PatrykSzydlik/SQuick_kicad/README.md

**Contributors:**

Piotr Gorzelnik

Patryk Szydlik

**Project:**

Squick Micromouse

**Brief:**

Repository contains all KiCAD projects related to development of electrical schematics and PCB board project.

**Repository Content:** 

 -- 	Squick (main KiCAD project)
