PatrykSzydlik/SQuick_kicad/Squick/Squick.kicad_pcb

## KiCad design Squick/Squick.kicad_pcb (2021-06-06)

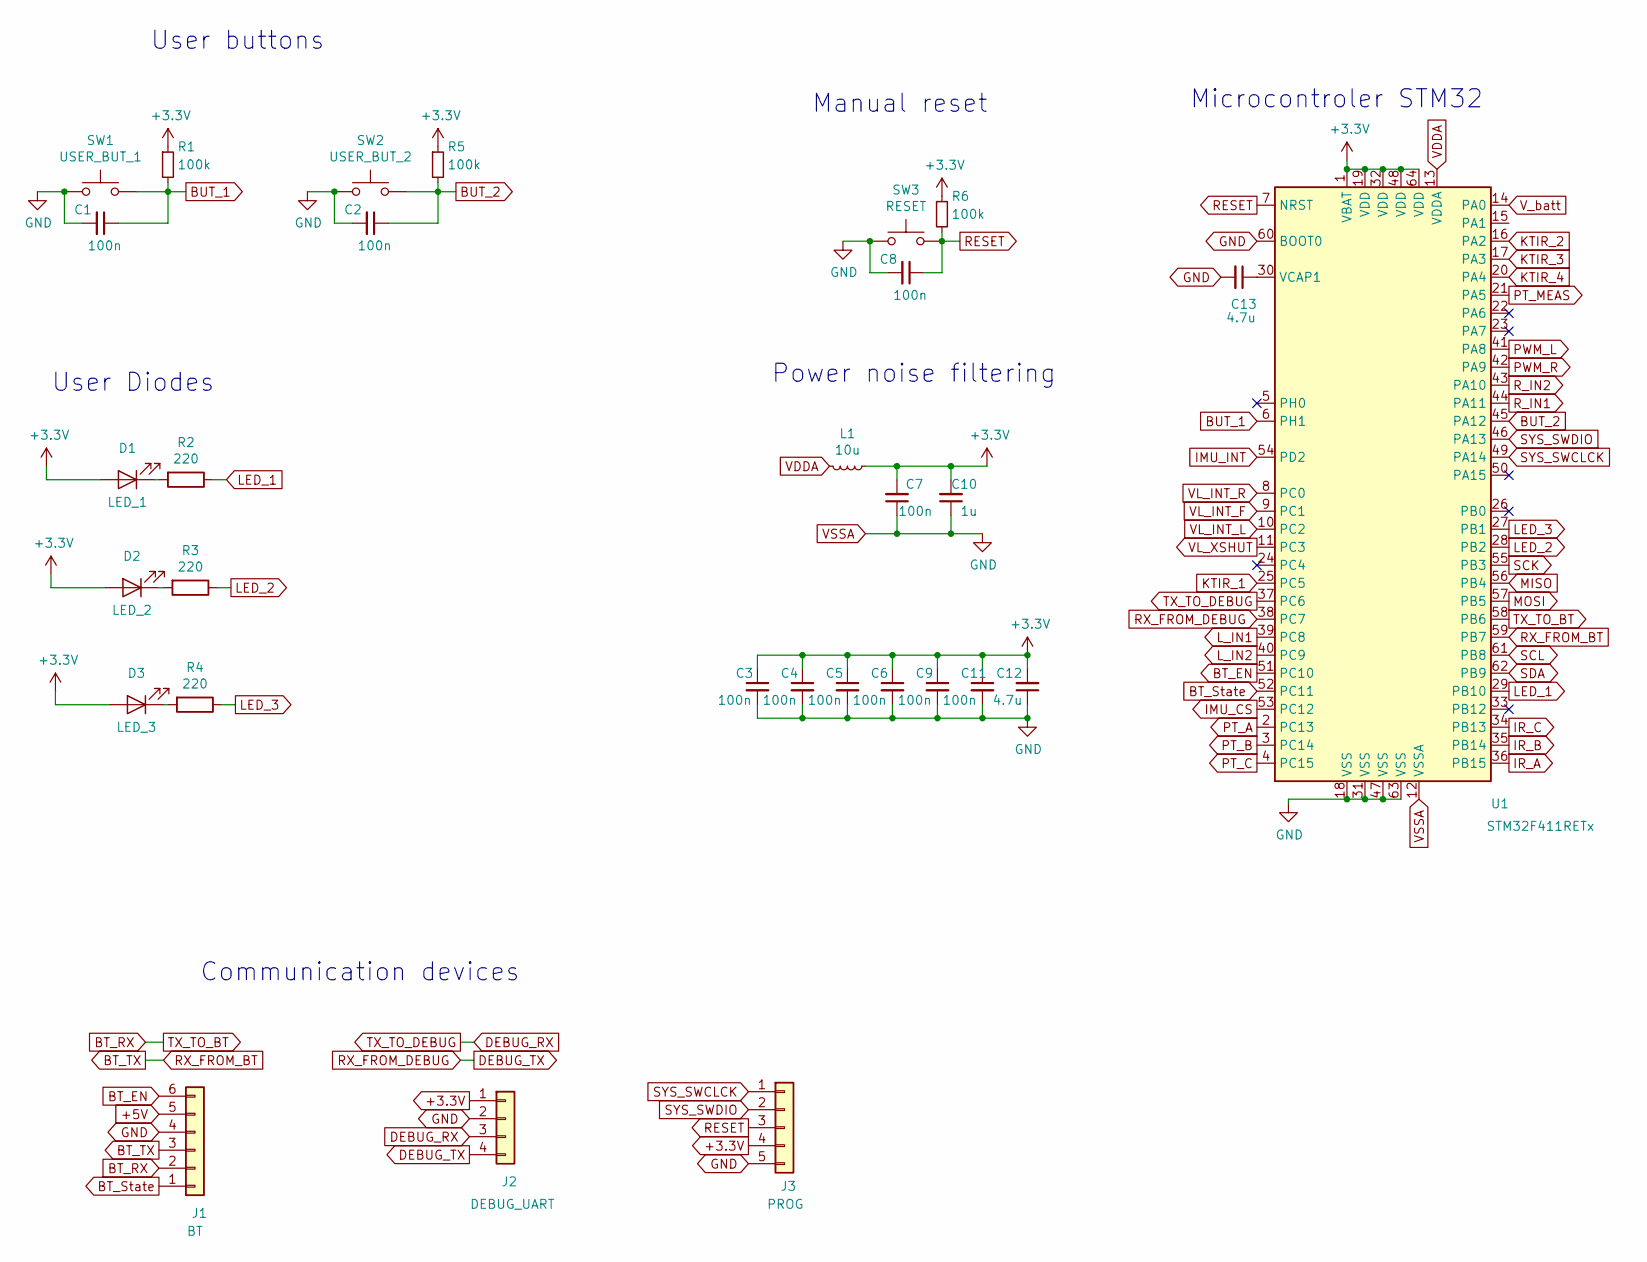
[picture p1: schematic STM32F4.sch]

Parts:
C1, C2, C3, C4, C5, C6, C7, C8, C9, C11: 100n; C_0603_1608Metric_Pad1.05x0.95mm_HandSolder
C10: 1u; C_0603_1608Metric_Pad1.05x0.95mm_HandSolder
C12, C13: 4.7u; C_0603_1608Metric_Pad1.05x0.95mm_HandSolder
D1: LED_1; LED_0603_1608Metric_Pad1.05x0.95mm_HandSolder
D2: LED_2; LED_0603_1608Metric_Pad1.05x0.95mm_HandSolder
D3: LED_3; LED_0603_1608Metric_Pad1.05x0.95mm_HandSolder
J1: BT; PinSocket_1x06_P2.54mm_Vertical
J2: DEBUG_UART; PinSocket_1x04_P2.54mm_Vertical
J3: PROG; PinSocket_1x05_P2.54mm_Vertical
L1: 10u; L_0603_1608Metric_Pad1.05x0.95mm_HandSolder
R1, R5, R6: 100k; R_0603_1608Metric_Pad1.05x0.95mm_HandSolder
R2, R3, R4: 220; R_0603_1608Metric_Pad1.05x0.95mm_HandSolder
SW1: USER_BUT_1; SW_DIP_SPSTx01_Slide_6.7x4.1mm_W6.73mm_P2.54mm_LowProfile_J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
SW2: USER_BUT_2; SW_DIP_SPSTx01_Slide_6.7x4.1mm_W6.73mm_P2.54mm_LowProfile_J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
SW3: RESET; SW_DIP_SPSTx01_Slide_6.7x4.1mm_W6.73mm_P2.54mm_LowProfile_J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
U1: STM32F411RETx; LQFP-64_10x10mm_P0.5mm

Connections:
+3.3V: C3.1, C4.1, C5.1, C6.1, C7.2, C9.1, C10.2, C11.1, C12.2, D1.2 (A), D2.2 (A), D3.2 (A), J2.1, J3.4, L1.1, R1.1, R5.1, R6.1, U1.1 (VBAT), U1.19 (VDD), U1.32 (VDD), U1.48 (VDD), U1.64 (VDD); also elsewhere on the board
+5V: J1.5; also elsewhere on the board
BT_EN: J1.6, U1.51 (PC10)
BT_RX: J1.2, U1.58 (PB6)
BT_State: J1.1, U1.52 (PC11)
BT_TX: J1.3, U1.59 (PB7)
BUT_1: C1.1, R1.2, SW1.2, U1.6 (PH1)
BUT_2: C2.1, R5.2, SW2.2, U1.45 (PA12)
DEBUG_RX: J2.3, U1.37 (PC6)
DEBUG_TX: J2.4, U1.38 (PC7)
GND: C1.2, C2.2, C3.2, C4.2, C5.2, C6.2, C7.1, C8.2, C9.2, C10.1, C11.2, C12.1, C13.2, J1.4, J2.2, J3.5, SW1.1, SW2.1, SW3.1, U1.12 (VSSA), U1.18 (VSS), U1.31 (VSS), U1.47 (VSS), U1.60 (BOOT0), U1.63 (VSS); also elsewhere on the board
IMU_CS: U1.53 (PC12); also elsewhere on the board
IMU_INT: U1.54 (PD2); also elsewhere on the board
IR_A: U1.36 (PB15); also elsewhere on the board
IR_B: U1.35 (PB14); also elsewhere on the board
IR_C: U1.34 (PB13); also elsewhere on the board
KTIR_1: U1.15 (PA1); also elsewhere on the board
KTIR_2: U1.16 (PA2); also elsewhere on the board
KTIR_3: U1.17 (PA3); also elsewhere on the board
KTIR_4: U1.20 (PA4); also elsewhere on the board
LED_1: R2.1, U1.29 (PB10)
LED_2: R3.1, U1.28 (PB2)
LED_3: R4.1, U1.27 (PB1)
L_IN1: U1.39 (PC8); also elsewhere on the board
L_IN2: U1.40 (PC9); also elsewhere on the board
MISO: U1.56 (PB4); also elsewhere on the board
MOSI: U1.57 (PB5); also elsewhere on the board
unnamed: C13.1, U1.30 (VCAP1)
unnamed: D1.1 (K), R2.2
unnamed: D2.1 (K), R3.2
unnamed: D3.1 (K), R4.2
PT_A: U1.2 (PC13); also elsewhere on the board
PT_B: U1.3 (PC14); also elsewhere on the board
PT_C: U1.4 (PC15); also elsewhere on the board
PT_MEAS: U1.21 (PA5); also elsewhere on the board
PWM_L: U1.41 (PA8); also elsewhere on the board
PWM_R: U1.42 (PA9); also elsewhere on the board
RESET: C8.1, J3.3, R6.2, SW3.2, U1.7 (NRST)
R_IN1: U1.44 (PA11); also elsewhere on the board
R_IN2: U1.43 (PA10); also elsewhere on the board
SCK: U1.55 (PB3); also elsewhere on the board
SCL: U1.61 (PB8); also elsewhere on the board
SDA: U1.62 (PB9); also elsewhere on the board
SYS_SWCLCK: J3.1, U1.49 (PA14)
SYS_SWDIO: J3.2, U1.46 (PA13)
VDDA: L1.2, U1.13 (VDDA)
VL_INT_F: U1.9 (PC1); also elsewhere on the board
VL_INT_L: U1.10 (PC2); also elsewhere on the board
VL_INT_R: U1.8 (PC0); also elsewhere on the board
VL_XSHUT: U1.11 (PC3); also elsewhere on the board
V_batt: U1.14 (PA0); also elsewhere on the board

Notes on the sheet:
Communication devices
Power noise filtering
Manual reset
Microcontroler STM32
User buttons
User Diodes

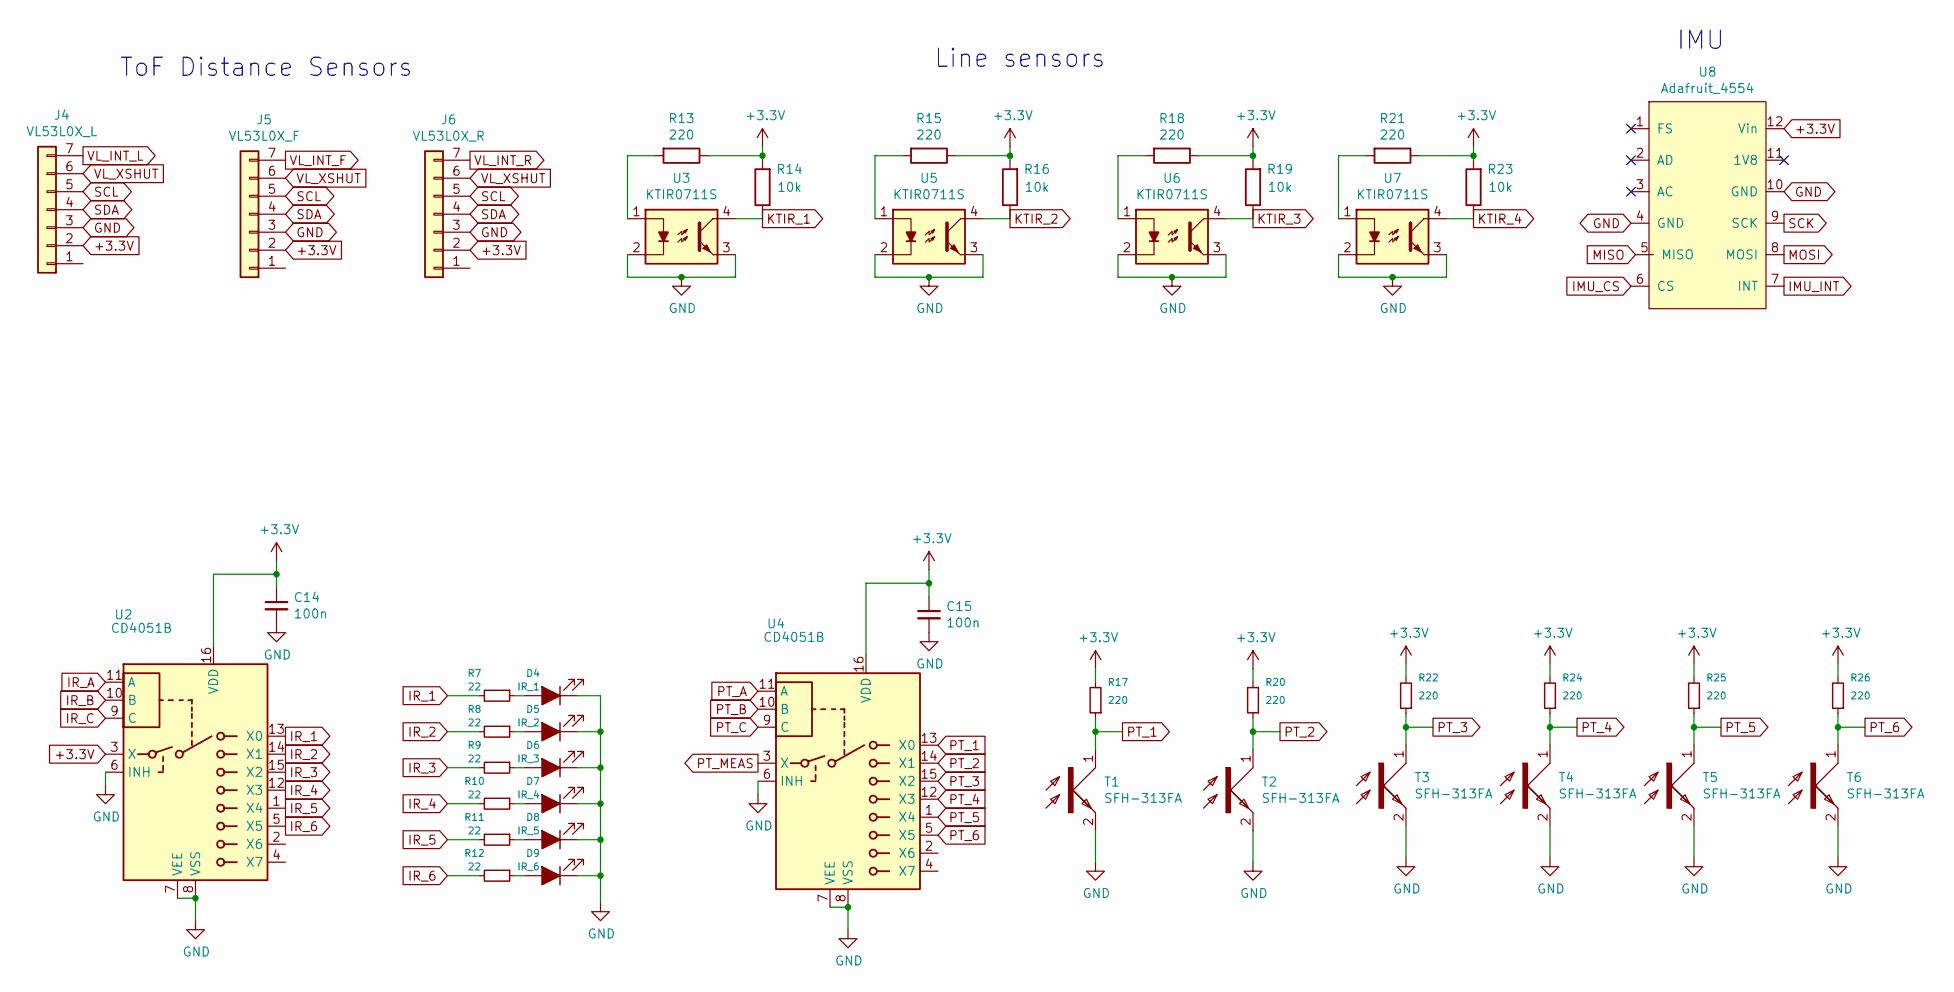
[picture p2: schematic Sensors.sch]

Parts:
C14, C15: 100n; C_0603_1608Metric_Pad1.05x0.95mm_HandSolder
D4: IR_1; LED_D5.0mm
D5: IR_2; LED_D5.0mm
D6: IR_3; LED_D5.0mm
D7: IR_4; LED_D5.0mm
D8: IR_5; LED_D5.0mm
D9: IR_6; LED_D5.0mm
J4: VL53L0X_L; PinSocket_1x07_P2.54mm_Vertical
J5: VL53L0X_F; PinSocket_1x07_P2.54mm_Vertical
J6: VL53L0X_R; PinSocket_1x07_P2.54mm_Vertical
R7, R8, R9, R10, R11, R12: 22; R_0603_1608Metric_Pad1.05x0.95mm_HandSolder
R13, R15, R17, R18, R20, R21, R22, R24, R25, R26: 220; R_0603_1608Metric_Pad1.05x0.95mm_HandSolder
R14, R16, R19, R23: 10k; R_0603_1608Metric_Pad1.05x0.95mm_HandSolder
T1, T2, T3, T4, T5, T6: SFH-313FA; LED_D5.0mm
U2, U4: CD4051B; SOIC-16W_5.3x10.2mm_P1.27mm
U3, U5, U6, U7: KTIR0711S
U8: Adafruit_4554; IMU_LSM9DS1_Adafruit4634

Connections:
+3.3V: C14.1, C15.1, J4.2, J5.2, J6.2, R13.1, R14.2, R15.1, R16.2, R17.2, R18.1, R19.2, R20.2, R21.1, R22.2, R23.2, R24.2, R25.2, R26.2, U2.3 (X), U2.16 (VDD), U4.16 (VDD), U8.12 (Vin); also elsewhere on the board
GND: C14.2, C15.2, D4.1 (K), D5.1 (K), D6.1 (K), D7.1 (K), D8.1 (K), D9.1 (K), J4.3, J5.3, J6.3, T1.2, T2.2, T3.2, T4.2, T5.2, T6.2, U2.6 (INH), U2.7 (VEE), U2.8 (VSS), U3.2, U3.3, U4.6 (INH), U4.7 (VEE), U4.8 (VSS), U5.2, U5.3, U6.2, U6.3, U7.2, U7.3, U8.4 (GND), U8.10 (GND); also elsewhere on the board
IMU_CS: U8.6 (CS); also elsewhere on the board
IMU_INT: U8.7 (INT); also elsewhere on the board
IR_1: R7.2, U2.13 (X0)
IR_2: R8.2, U2.14 (X1)
IR_3: R9.2, U2.15 (X2)
IR_4: R10.2, U2.12 (X3)
IR_5: R11.2, U2.1 (X4)
IR_6: R12.2, U2.5 (X5)
IR_A: U2.11 (A); also elsewhere on the board
IR_B: U2.10 (B); also elsewhere on the board
IR_C: U2.9 (C); also elsewhere on the board
KTIR_1: R14.1, U3.4; also elsewhere on the board
KTIR_2: R16.1, U5.4; also elsewhere on the board
KTIR_3: R19.1, U6.4; also elsewhere on the board
KTIR_4: R23.1, U7.4; also elsewhere on the board
MISO: U8.5 (MISO); also elsewhere on the board
MOSI: U8.8 (MOSI); also elsewhere on the board
unnamed: D4.2 (A), R7.1
unnamed: D5.2 (A), R8.1
unnamed: D6.2 (A), R9.1
unnamed: D7.2 (A), R10.1
unnamed: D8.2 (A), R11.1
unnamed: D9.2 (A), R12.1
unnamed: R13.2, U3.1
unnamed: R15.2, U5.1
unnamed: R18.2, U6.1
unnamed: R21.2, U7.1
PT_1: R17.1, T1.1, U4.13 (X0)
PT_2: R20.1, T2.1, U4.14 (X1)
PT_3: R22.1, T3.1, U4.15 (X2)
PT_4: R24.1, T4.1, U4.12 (X3)
PT_5: R25.1, T5.1, U4.1 (X4)
PT_6: R26.1, T6.1, U4.5 (X5)
PT_A: U4.11 (A); also elsewhere on the board
PT_B: U4.10 (B); also elsewhere on the board
PT_C: U4.9 (C); also elsewhere on the board
PT_MEAS: U4.3 (X); also elsewhere on the board
SCK: U8.9 (SCK); also elsewhere on the board
SCL: J4.5, J5.5, J6.5; also elsewhere on the board
SDA: J4.4, J5.4, J6.4; also elsewhere on the board
VL_INT_F: J5.7; also elsewhere on the board
VL_INT_L: J4.7; also elsewhere on the board
VL_INT_R: J6.7; also elsewhere on the board
VL_XSHUT: J4.6, J5.6, J6.6; also elsewhere on the board

Notes on the sheet:
ToF Distance Sensors
IMU
Line sensors

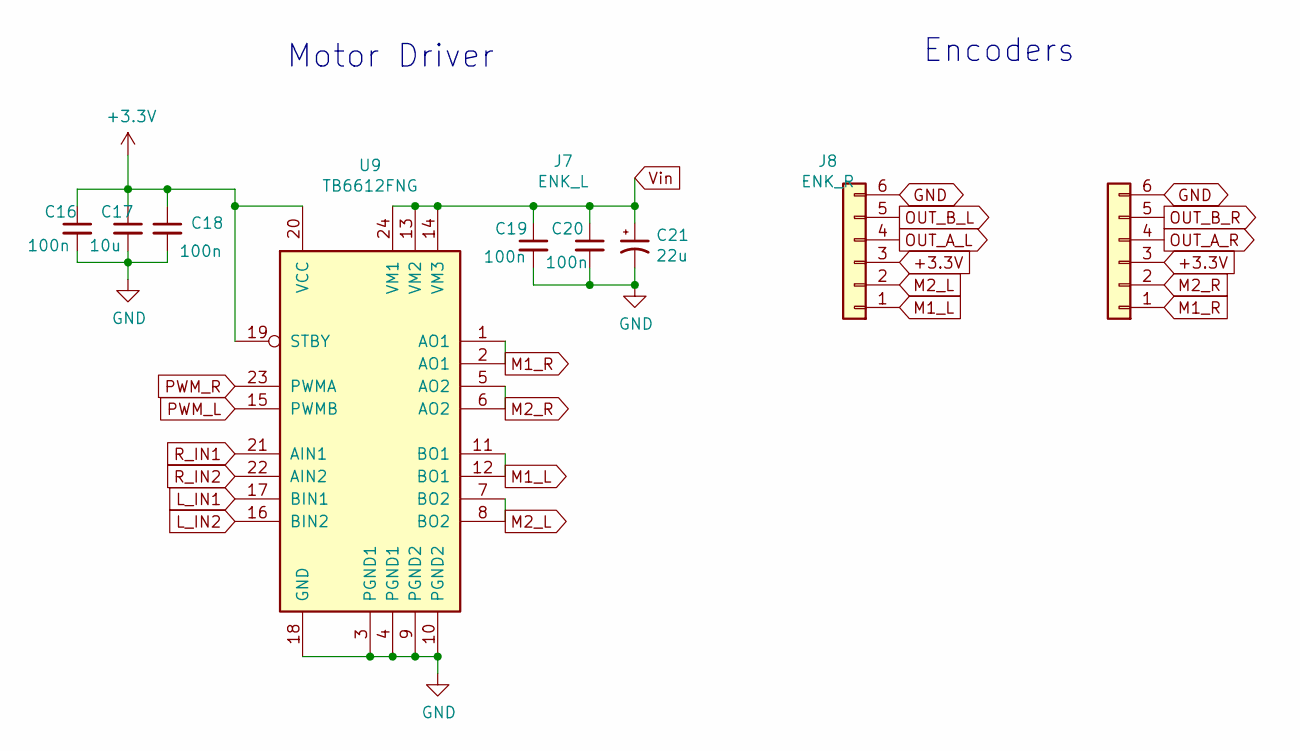
[picture p3: schematic Motor_driver.sch]

Parts:
C16, C18, C19, C20: 100n; C_0603_1608Metric_Pad1.05x0.95mm_HandSolder
C17: 10u; C_0603_1608Metric_Pad1.05x0.95mm_HandSolder
C21: 22u; CP_EIA-6032-28_Kemet-C_Pad2.25x2.35mm_HandSolder
J7: ENK_L; PinSocket_1x06_P2.00mm_Vertical
J8: ENK_R; PinSocket_1x06_P2.00mm_Vertical
U9: TB6612FNG; SSOP-24_5.3x8.2mm_P0.65mm

Connections:
+3.3V: C16.1, C17.1, C18.1, J7.3, J8.3, U9.19 (STBY), U9.20 (VCC); also elsewhere on the board
GND: C16.2, C17.2, C18.2, C19.2, C20.2, C21.2, J7.6, J8.6, U9.3 (PGND1), U9.4 (PGND1), U9.9 (PGND2), U9.10 (PGND2), U9.18 (GND); also elsewhere on the board
L_IN1: U9.17 (BIN1); also elsewhere on the board
L_IN2: U9.16 (BIN2); also elsewhere on the board
M1_L: J7.1, U9.11 (BO1), U9.12 (BO1)
M1_R: J8.1, U9.1 (AO1), U9.2 (AO1)
M2_L: J7.2, U9.7 (BO2), U9.8 (BO2)
M2_R: J8.2, U9.5 (AO2), U9.6 (AO2)
OUT_A_L: J7.4
OUT_A_R: J8.4
OUT_B_L: J7.5
OUT_B_R: J8.5
PWM_L: U9.15 (PWMB); also elsewhere on the board
PWM_R: U9.23 (PWMA); also elsewhere on the board
R_IN1: U9.21 (AIN1); also elsewhere on the board
R_IN2: U9.22 (AIN2); also elsewhere on the board
Vin: C19.1, C20.1, C21.1, U9.13 (VM2), U9.14 (VM3), U9.24 (VM1); also elsewhere on the board

Notes on the sheet:
Motor Driver
Encoders

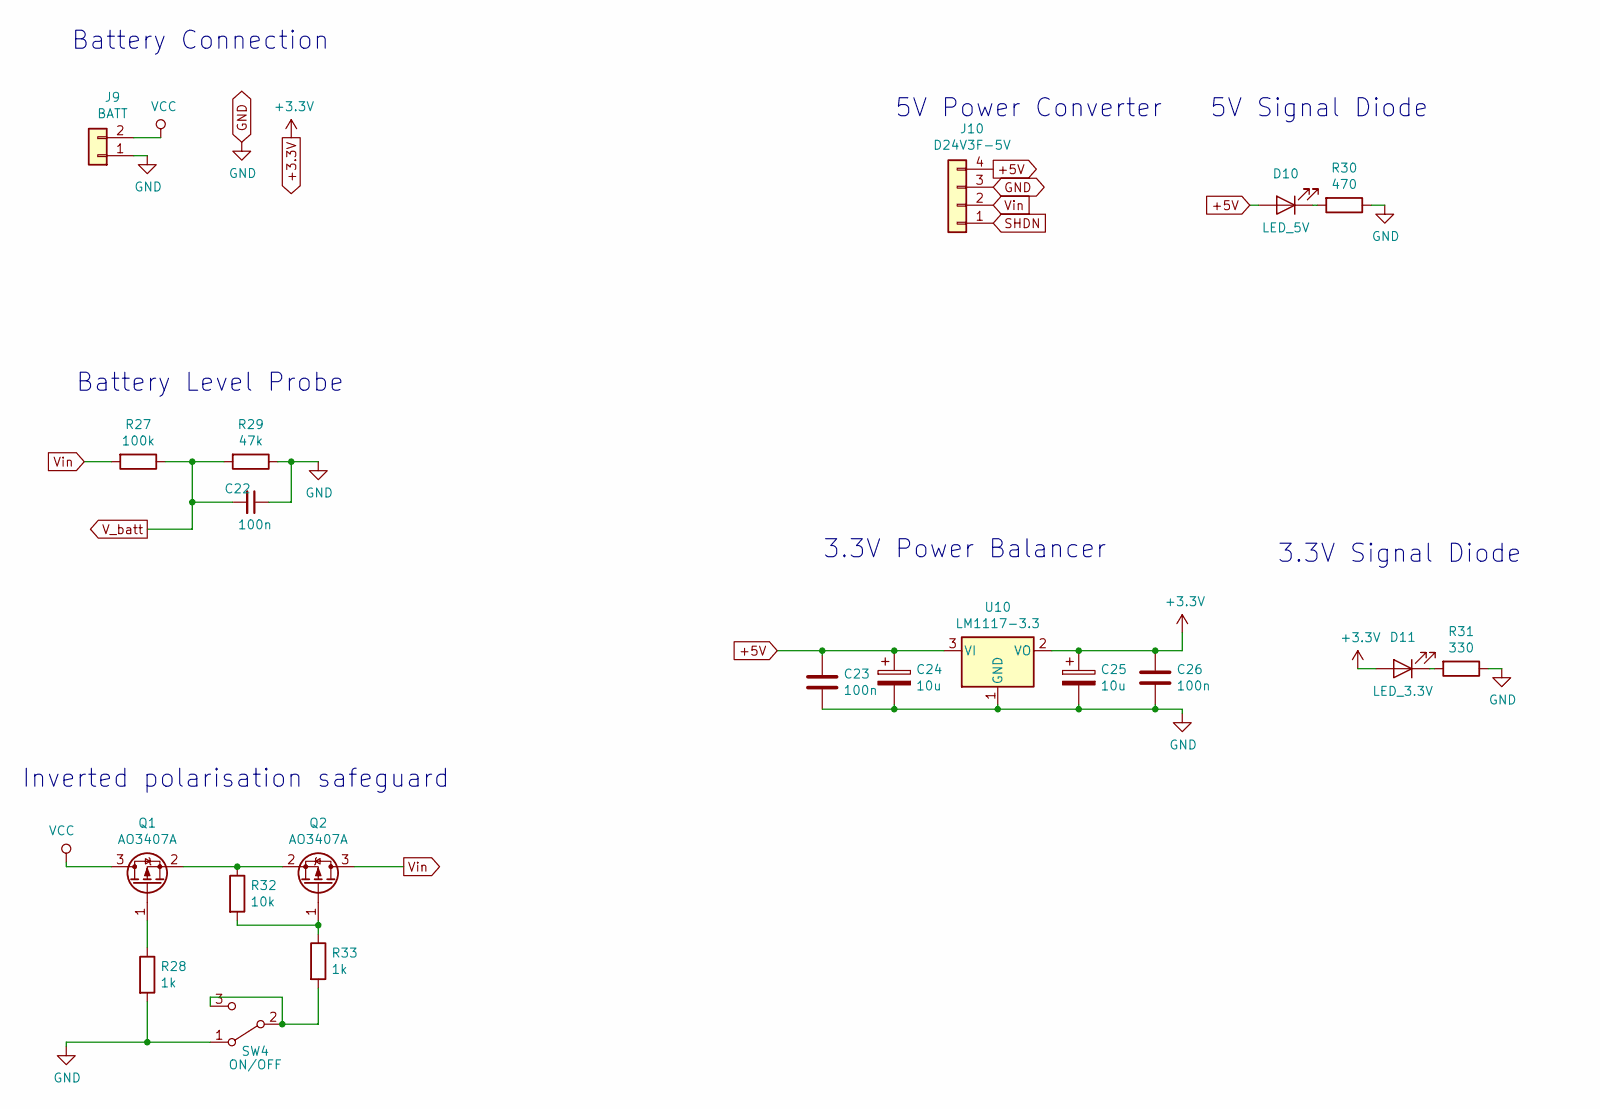
[picture p4: schematic Power_supply.sch]

Parts:
C22, C23, C26: 100n; C_0603_1608Metric_Pad1.05x0.95mm_HandSolder
C24, C25: 10u; CP_EIA-3216-18_Kemet-A_Pad1.58x1.35mm_HandSolder
D10: LED_5V; LED_0603_1608Metric_Pad1.05x0.95mm_HandSolder
D11: LED_3.3V; LED_0603_1608Metric_Pad1.05x0.95mm_HandSolder
J9: BATT; PinSocket_1x02_P2.54mm_Vertical
J10: D24V3F-5V; PinSocket_1x04_P2.54mm_Vertical
Q1, Q2: AO3407A; SOT-23_Handsoldering
R27: 100k; R_0603_1608Metric_Pad1.05x0.95mm_HandSolder
R28, R33: 1k; R_0603_1608Metric_Pad1.05x0.95mm_HandSolder
R29: 47k; R_0603_1608Metric_Pad1.05x0.95mm_HandSolder
R30: 470; R_0603_1608Metric_Pad1.05x0.95mm_HandSolder
R31: 330; R_0603_1608Metric_Pad1.05x0.95mm_HandSolder
R32: 10k; R_0603_1608Metric_Pad1.05x0.95mm_HandSolder
SW4: ON/OFF; PinSocket_1x03_P2.54mm_Vertical
U10: LM1117-3.3; SOT-223-3_TabPin2

Connections:
+3.3V: C25.1, C26.1, D11.2 (A), U10.2 (VO); also elsewhere on the board
+5V: C23.1, C24.1, D10.2 (A), J10.4, U10.3 (VI); also elsewhere on the board
GND: C22.1, C23.2, C24.2, C25.2, C26.2, J9.1, J10.3, R28.2, R29.1, R30.1, R31.1, SW4.1 (A), U10.1 (GND); also elsewhere on the board
unnamed: D10.1 (K), R30.2
unnamed: D11.1 (K), R31.2
unnamed: Q1.1 (G), R28.1
unnamed: Q1.2 (S), Q2.2 (S), R32.1
unnamed: Q2.1 (G), R32.2, R33.1
unnamed: R33.2, SW4.2 (B), SW4.3 (C)
SHDN: J10.1
VCC: J9.2, Q1.3 (D)
V_batt: C22.2, R27.1, R29.2; also elsewhere on the board
Vin: J10.2, Q2.3 (D), R27.2; also elsewhere on the board

Notes on the sheet:
Battery Connection
Inverted polarisation safeguard
5V Power Converter
3.3V Power Balancer
5V Signal Diode
3.3V Signal Diode
Battery Level Probe

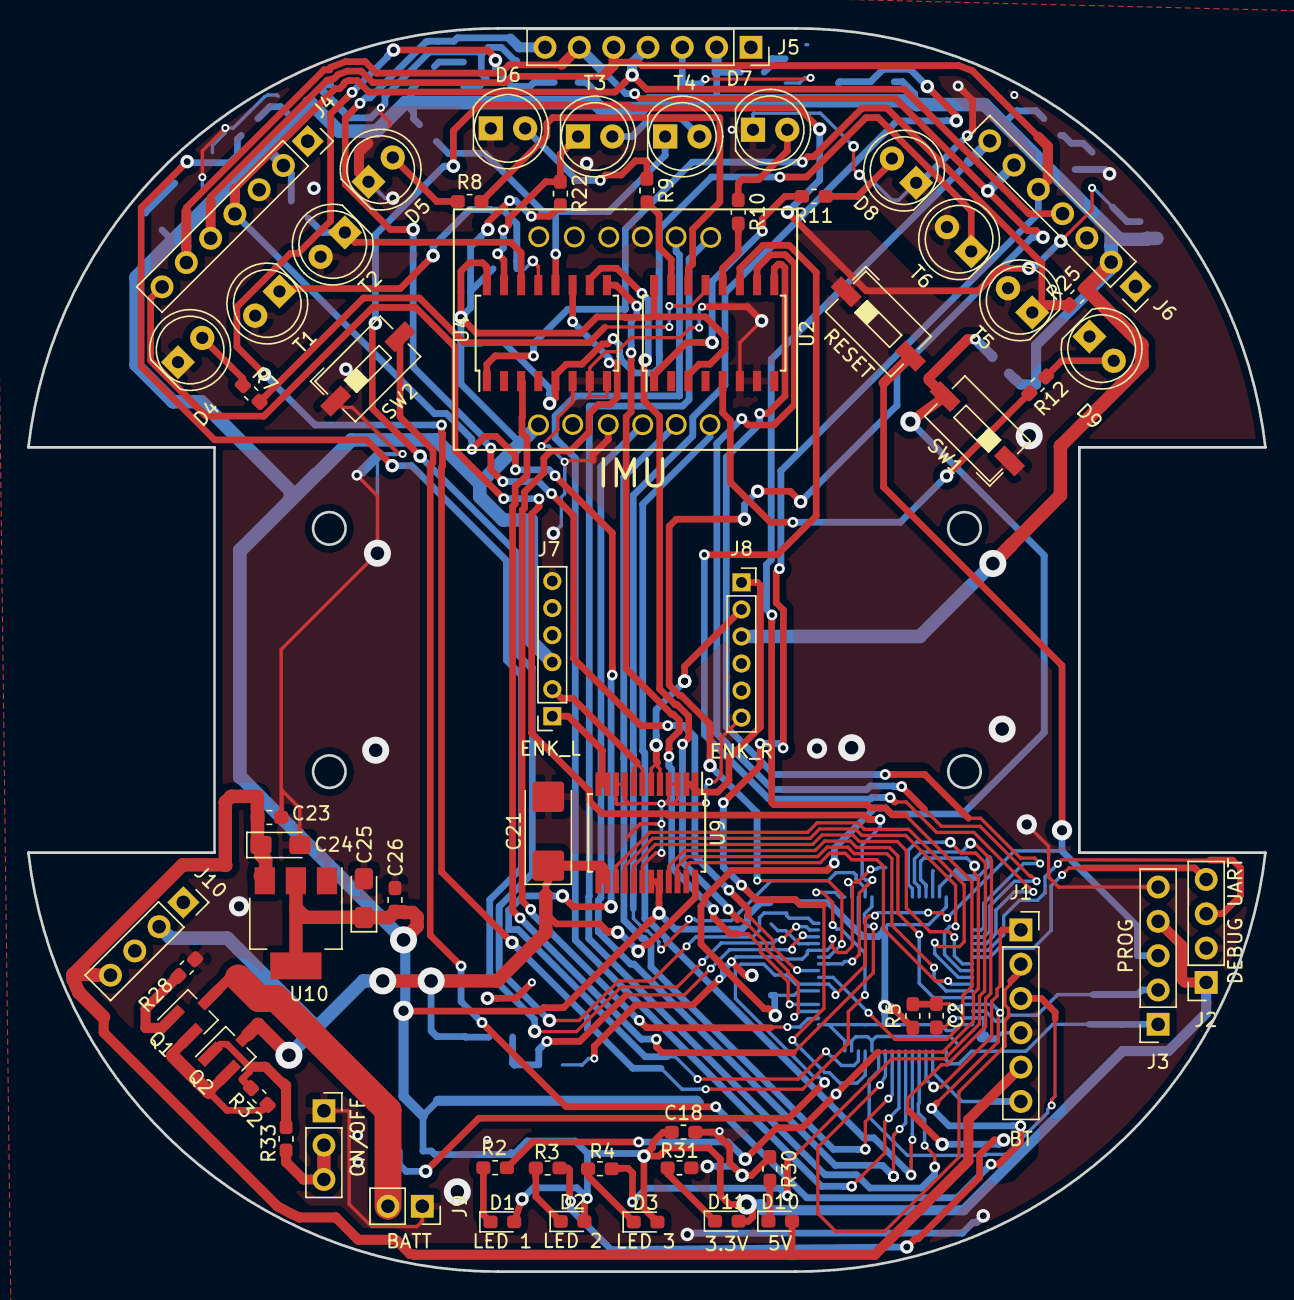
[picture p5: board Squick.kicad_pcb from above]

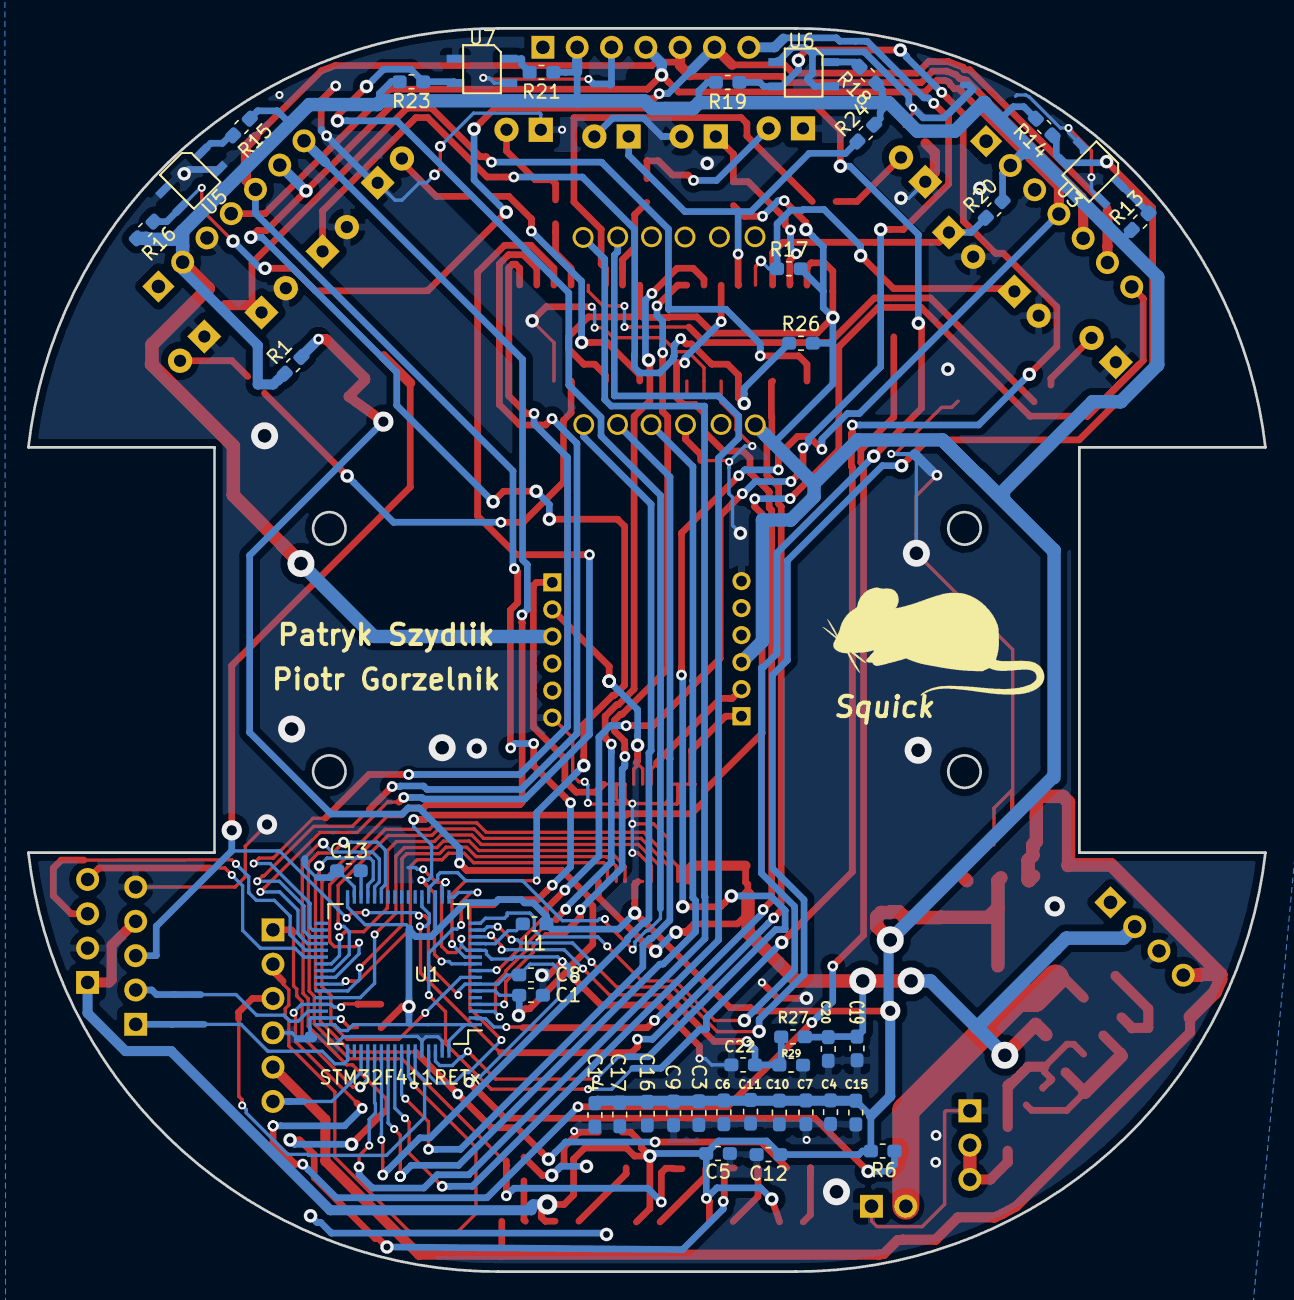
[picture p6: board Squick.kicad_pcb from below]

Board: 2 copper layers, 91.5 x 92.0 mm, 103 parts (41 on the bottom side), 85 nets.
