PatrykSzydlik/SQuick_kicad/(commit log)

2021-03-07 First day of work
    [Squick.kicad_pcb, Squick.sch]
2021-03-09 New progress in work
    [Squick.sch]
2021-03-09 End for today. Almost finished
    [Squick.sch]
2021-03-12 Updating schemes and libraries
    [Motor_driver.sch, Power_supply.sch, STM32F4.sch, Sensors.sch]
2021-03-12 Finished electrical scheme
    [STM32F4.sch]
2021-03-13 Assigned PCB footprints to schematic symbols and added footprints for KTIR and tact switches
2021-03-14 Created footprint for IMU
    [Sensors.sch]
2021-03-14 Updated pin PT_MEAS
    [Motor_driver.sch, Power_supply.sch, STM32F4.sch, Sensors.sch]
2021-03-15 Fixed footprints and symbol
    [Motor_driver.sch, Power_supply.sch, STM32F4.sch, Sensors.sch]
2021-03-16 Progress with PCB and some footprint debugs
    [Motor_driver.sch, Power_supply.sch, STM32F4.sch, Sensors.sch, Squick.kicad_pcb]
2021-03-17 Progress with PCB and size reducement
    [Squick.kicad_pcb]
2021-03-20 Major progress with PCB design
    [Power_supply.sch, Squick.kicad_pcb]
2021-03-20 PCB project almost finished (without connections)
    [Power_supply.sch, Squick.kicad_pcb]
2021-03-21 Changed IMU and assigned 0603 footprints
    [Motor_driver.sch, Power_supply.sch, STM32F4.sch, Sensors.sch, Squick.kicad_pcb, Squick.sch]
2021-03-21 some debugs and small changes
    [Motor_driver.sch, Power_supply.sch, STM32F4.sch, Sensors.sch, Squick.kicad_pcb, Squick.sch]
2021-03-21 Started connecting pads
    [Squick.kicad_pcb]
2021-03-22 Connecting is not funny anymore
    [Squick.kicad_pcb]
2021-03-24 Optimalization of connections and some reorganizations. Light in the tunnel
    [Squick.kicad_pcb]
2021-03-24 Almost finished. It's getting really tight
    [Squick.kicad_pcb]
2021-03-28 Everything connected
    [Squick.kicad_pcb]
2021-03-29 Improved via drills and added graphic symbols
    [Squick.kicad_pcb]
2021-03-29 Made more space for BT module and 5V converter
    [Squick.kicad_pcb]
2021-03-30 PCB project done
    [Squick.kicad_pcb]
2021-03-31 Created GND planes
    [Squick.kicad_pcb]
2021-03-31 3 GND connections to go
    [Squick.kicad_pcb]
2021-03-31 PCB project done!
    [Squick.kicad_pcb]
2021-04-07 Last small debugs
    [Squick.kicad_pcb]
2021-04-10 Wygenerowano gerbery do produkcji płytki
    [Squick.kicad_pcb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]
2021-04-12 Generated missing drill file
    [Squick-B.Cu.gbr, Squick-B.Mask.gbr, Squick-B.SilkS.gbr, Squick-Edge.Cuts.gbr, Squick-F.Cu.gbr, Squick-F.Mask.gbr, Squick-F.SilkS.gbr, Squick-NPTH.drl]
2021-04-25 Zaległa aktualizacja gerberów
2021-06-06 Updated schemes with hot-fixes
    [Motor_driver.sch, Power_supply.sch, STM32F4.sch, Sensors.sch, Squick.kicad_pcb, Squick.sch]
